natapol2547/YBR-Tawan/Robot Documentation/YBR-Tawan.pdf

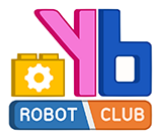
[picture p3: figure]

## YBR-Tawan

## WRO Future Engineer

## Documentation

## (Thai-version)

เอกสารนแบ่ง ี้ ออกเป็น

1. รูปภาพทีมงานและรถ
2. ข้อมูลทางวิศวกรรม
2.1 | การจัดการการเคลื่อนไหว
2.2 | การจัดการพลังงานและการตรวจเช็ค
2.3 | การจัดการอุปสรรค
2.4 | ปัจจัยทางวิศวกรรม
3. Youtube Link
4. Github link

## รูปภาพหุ่น

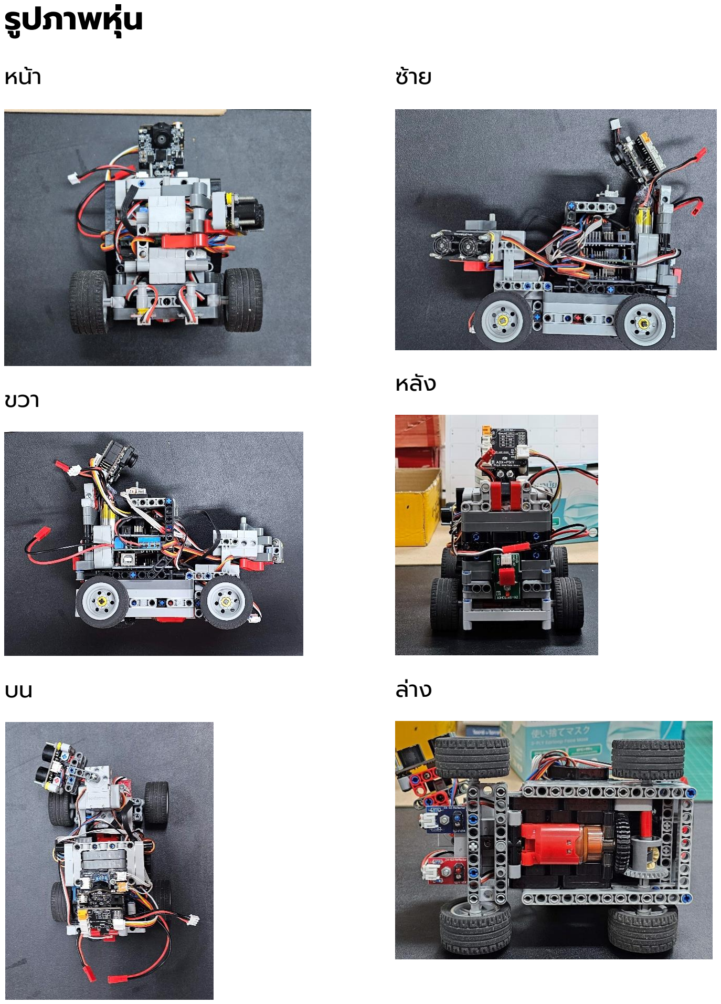
[picture p4: page 3]

หน้า

ขวา

บน

ซ้าย

หลัง

ล่าง

## รูปภาพทีมงาน

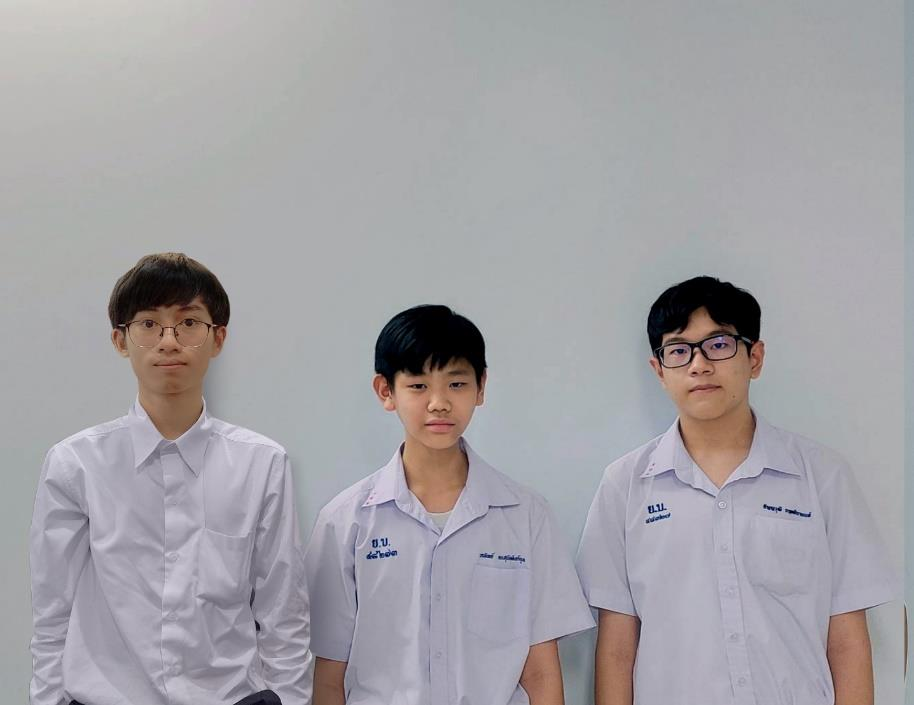
[picture p5: figure]
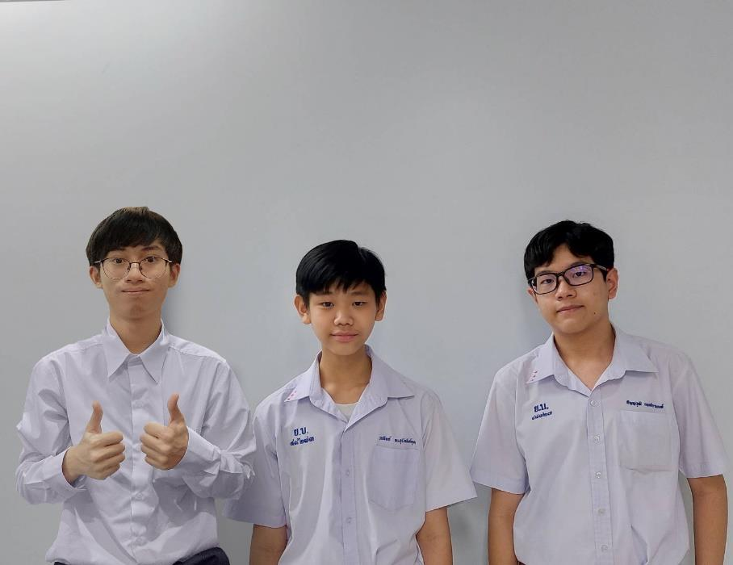
[picture p6: figure]

## 2. ข้อมูลทางวิศวกรรม

### 2.1 การจัดการการเคลื่อนไหว

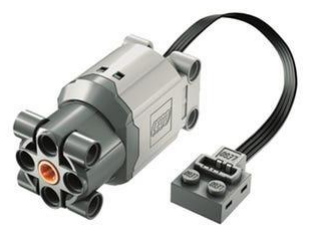
[picture p7: figure]

### เราใช้ Power Functions L-Motor ใน การขับเคลื่อนของหุ่น

เป็นมอเตอรท์ ี่ง่ายและ เราเลือกมอเตอร์นี้เนื่องจาก ความง่ายต่อการเชื่อมต่อมอเตอรเข้ากับ ์ หุ่นยนต์ของ เรา และมอเตอร์นกี้ ็มีราคาที่ถกู อีกดว้ ย

ข้อมูลทางเทคนิค

น ้าหนัก:

ความเร็วสูงสุด และ ปริมาณ
กระแสไฟฟ้า

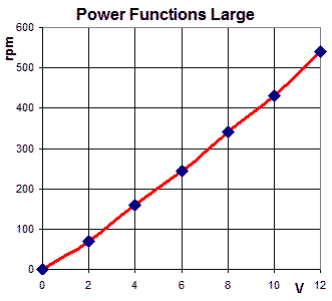
[picture p8: figure]

ความเร็ว เทียบกับ volt

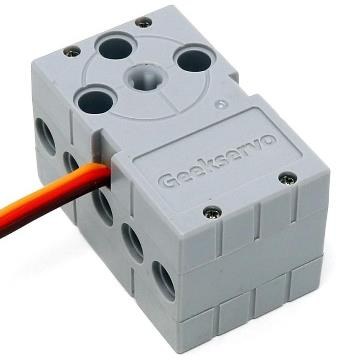
[picture p9: figure]

### เราใช้ Geekservo 2kg 360 Degrees ในการเลี้ยวของหุ่น และใช้หมุน Ultrasonic

### Sensor

เป็น servo ที่ใช้ได้กับ LEGO ใช้ง่ายและสะดวกต่อการ

สร้างหุ่น

ข้อมูลทางเทคนิค

- ความเร็วในการหมุนแกน 60 องศา/0.12 วินาที
- แรงบิด 2 กิโลกรัม.เซนตเิมตร ทไี่ ฟเลี้ยง 4.8V
- กระแสไฟฟ้าขณะไม่มีโหลด 20 ถึง 50mA
- กระแสไฟฟ้าขณะบังคับแกนหมุน (Stall) 600 ถึง 700mA
- กระแสไฟฟ้าสงบขณะหยุดท างาน 7mA
- ความกว้างของสัญญาณพัลส์ที่ต้องการ 0.6 ถงึ 2.4 มิลลิวินาที
- หมุนได้ 0 ถึง 360 องศา

Code การหมุน servo

void steering_servo(int degree) {

servo1.write((90 + max(min(degree, 45), -45)) / 2); }

### 2.2 การจัดการพลังงานและการตรวจเช็ค

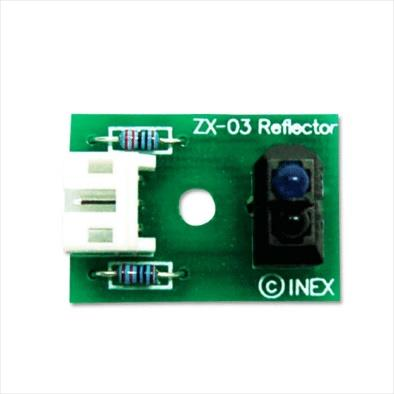
[picture p10: figure]

### เราใช้ ZX-03 Reflector ในการตรวจค่าสี บนสนาม 2 ตัว (แดง และ น ้าเงิน)

Light Reflector นี้เป็น sensor ที่ใช้วัดค่าแสงสะท้อน และในสนามนี้เราใช้sensor นี้เพื่อที่จะ check เส้น ตอนที่หุ่นเลี้ยว

### เราใช้sensor GY-25 เพื่อก าหนด

### ทิศทางของหุ่นยนต์ของเราบนสนาม

เนื่องจากหนุ่ จ าเปน็ ต้องเดินเป็นเส้นตรงเป็นส่วนใหญ่ เราจึงเลือกใช้ sensor gyro เพื่อให้หุ่นรู้ทิศทางตัว

มันเอง

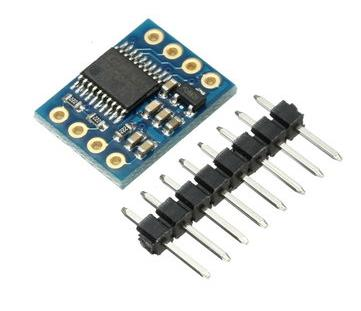
[picture p11: figure]

Dataset: http://mkpochtoi.ru/GY25_MANUAL_EN.pdf

Library: https://github.com/ElectronicCats/mpu6050

### เราใช้ Pixy 2.1 เพื่อตรวจจับสิ่งกีดขวางที่

### อยู่บนสนาม

Module กล้องตัวนี้มาพร้อม library และ function ที่ผู้พัฒนาของ pixy camera ได้ท าไว้แล้ว จึงง่ายต่อ

การใช้มาก

4’Documentaion:

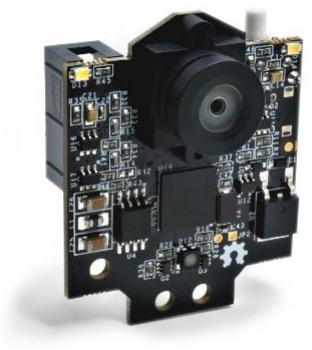
[picture p12: figure]

https://docs.pixycam.com/wiki/doku.php?id=wiki:v2:start

Software and Library: https://pixycam.com/downloads-pixy2/

### เราใช้ Ultrasonic Sensor ( SEN0307 ) เพื่อวัดระยะห่าง

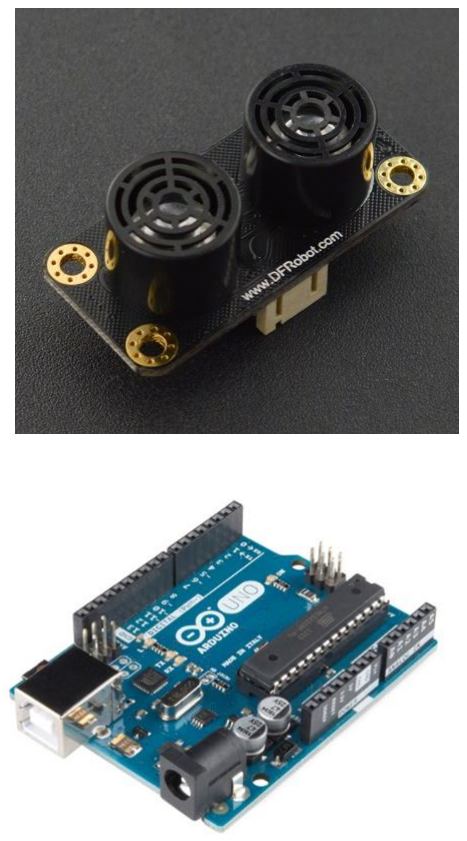
[picture p13: figure]

### ระหว่างหุ่นยนต์กับผนัง

Sensor ตัวนี้ใช้เอาต์พุตแรงดันไฟฟ้าแบบอะนาล็อก และให้การวัดระยะทางที่แม่นย าภายใน 2-500 ซม. ด้วย ความละเอียด 1 ซม. และความแม่นย า ±1% ซึ่มเหมาะกัน การแข่งขันนี้มาก

### เราใช้ Arduino UNO สมองส าหรับ

### หุ่นยนต์ของเรา

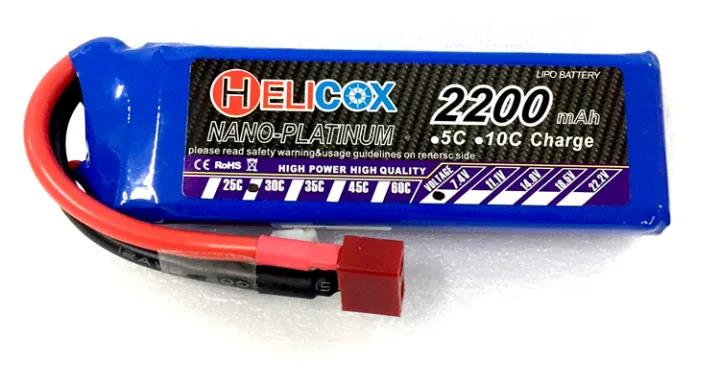
[picture p14: figure]

### เราใช้ แบตเตอรี่ลิโพ Helicox

### 2200mah (7.4V) เพื่อให้

### พลังงานหุ่นของเรา

การเดินสาย

// Motor

ENB -> Arduino UNO Pin 11

INB -> Arduino UNO Pin 13

// Servos

STEER_SRV -> Arduino UNO Pin 9

ULTRA_SRV -> Arduino UNO Pin 8

// Ultrasonic Sensor

ULTRA_DATA_PIN -> Arduino UNO Pin 2

// Light Sensors

RED_DATA_SEN -> Arduino UNO Pin 0

BLUE_DATA_SEN -> Arduino UNO Pin 1

// Button

BUTTON_DATA -> Arduino UNO Pin 3

// Pixy Camera

PIXY_SDA -> Arduino UNO Pin 4

PIXY_SCL -> Arduino UNO Pin 5

// Gryo

TX -> Arduino UNO RX

RX -> Arduino UNO TX

// Battery

BATTERY -> PWR_IN of Arduino UNO

### 2.3 การจัดการอุปสรรค

2.3.1 รอบคัดเลือก

ในรอบคัดเลือกหุ่นยนต์จะใช้ Ultrasonic sensor เพื่อค านวณระยะทางระหว่าง

ก าแพงของสนามกับหุ่น

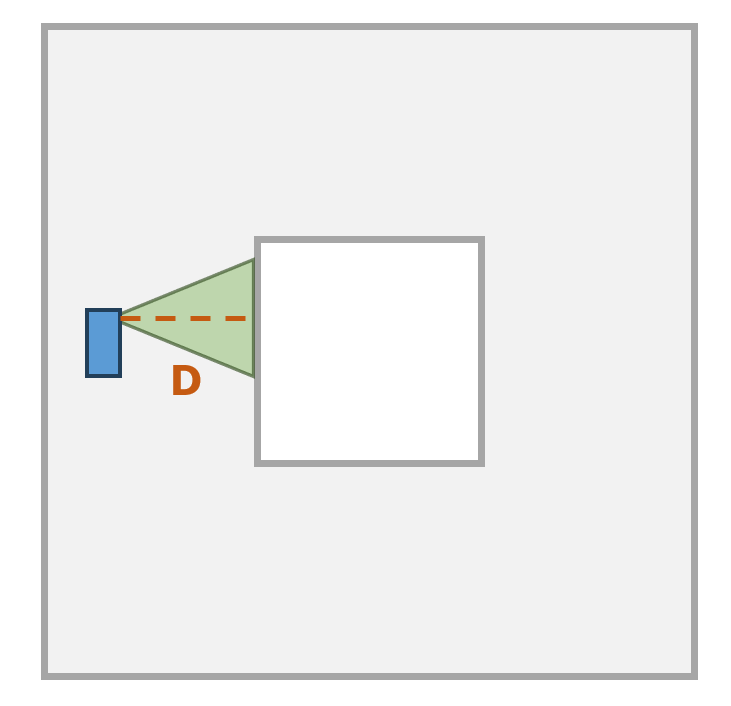
[picture p15: figure]
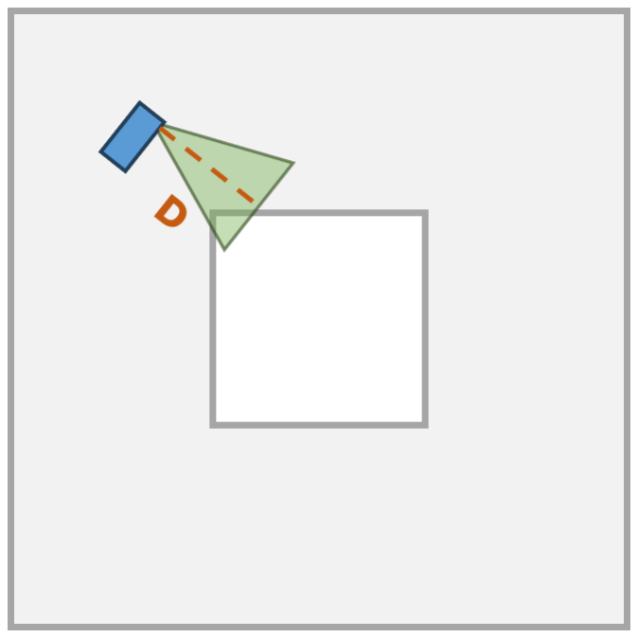
[picture p16: figure]

หุ่นจะน าระยะทางของหุ่นจากก าแพงและ องศาของ sensor gyro มาค านวณ เป็น steering degree (องศาการเลี้ยว) เพื่อใหห้ ุ่นคงระยะห่างระหว่างก าแพง

ได้ด้วยสูตร Proportional Integral Derivative (PID)

สูตรการเดิน

getIMU();

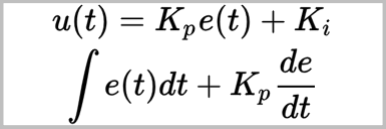
[picture p17: figure]

line_detection();
ultra_servo(pvYaw, TURN);
int wall_distance = getDistance();
motor_and_steer(-1 * compassPID.Run(pvYaw + ((wall_distance - 25) * 1) * ((float(TURN == 'R') - 0.5) * 2)));

2.3.2 รอบชิง

ในรอบคัดเลือกหุ่นยนต์จะใช้Pixy camera Ultrasonic sensor และ Gyro เพื่อน ามาค านวณ steering degree (องศาการเลยี้ ว)

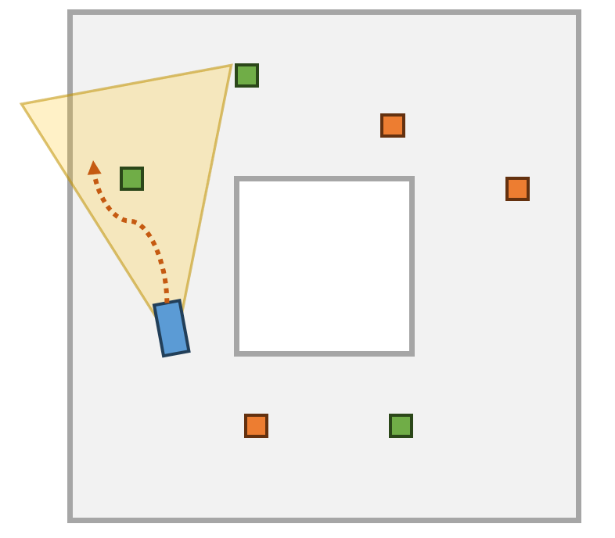
[picture p18: figure]

หุ่นยังคงใช้ PID เหมือนกับรอบคัดเลือก แตต่ ัวแปลทเี่ พิ่มขึ้นมาคือ avoidance degree (องศาในการเลี้ยวหลบ) โดย code จะเป็นดังต่อไปนี้

สูตรค านวนองศาในการเลี้ยวหลบ

float calculate_avoidance() {
int blocks = pixy.ccc.getBlocks();

found_block = false;

if (blocks) {
int signature = -1; | // Signature of the object you want to detect
int targetHeight = 10; | // Height of the object in centimeters
float focalLength = 2.3; // Focal length of the camera in centimeters float cameraFOV = 80.0; // Field of view of the camera in degrees

int largestBlockIndex = -1;
int largestBlockArea = 0;

for (int i = 0; i < blocks; i++) {
if (pixy.ccc.blocks[i].m_height > 1.33 * float(pixy.ccc.blocks[i].m_width)) {
int objectArea = pixy.ccc.blocks[i].m_width; // * pixy.ccc.blocks[i].m_height; found_block = true;
if (objectArea > largestBlockArea) { largestBlockIndex = i;
largestBlockArea = objectArea;
signature = pixy.ccc.blocks[i].m_signature; }
}
}

if (signature != -1) {
int objectHeight = pixy.ccc.blocks[largestBlockIndex].m_height; float distance = (targetHeight * focalLength * 100) / objectHeight;

float blockCenterX = pixy.ccc.blocks[largestBlockIndex].m_x; float blockCenterY = pixy.ccc.blocks[largestBlockIndex].m_y;

float deltaX = blockCenterX - pixy.frameWidth / 2;
float deltaY = blockCenterY - pixy.frameHeight / 2;

float detected_degree = deltaX * 40 / pixy.frameWidth;

float blockPositionX = distance * sin(degreesToRadians(detected_degree));
float blockPositionY = distance * cos(degreesToRadians(detected_degree))
- 17;

if (signature == 1) {

avoidance_degree = max(radiansToDegree(atan2(blockPositionX + 9, blockPositionY)), 5);
Blocks_TURN = 'R';
} else {
avoidance_degree = min(radiansToDegree(atan2(blockPositionX - 9, blockPositionY)), -5);
Blocks_TURN = 'L';
}
}
}

return avoidance_degree;
}

### 2.4 ปัจจัยทางวิศวกรรม

หุ่นที่เราสร้างขึ้นมาเป็นหุ่นที่ออกแบบมาเพื่อใช้ส าหรับงานนี้โดยเฉพาะ โดยใช้ ชิ้นส่วน LEGO และน็อตต่างๆ ในการยึดชิ้นส่วนของหุ่นเข้าดว้ ยกัน

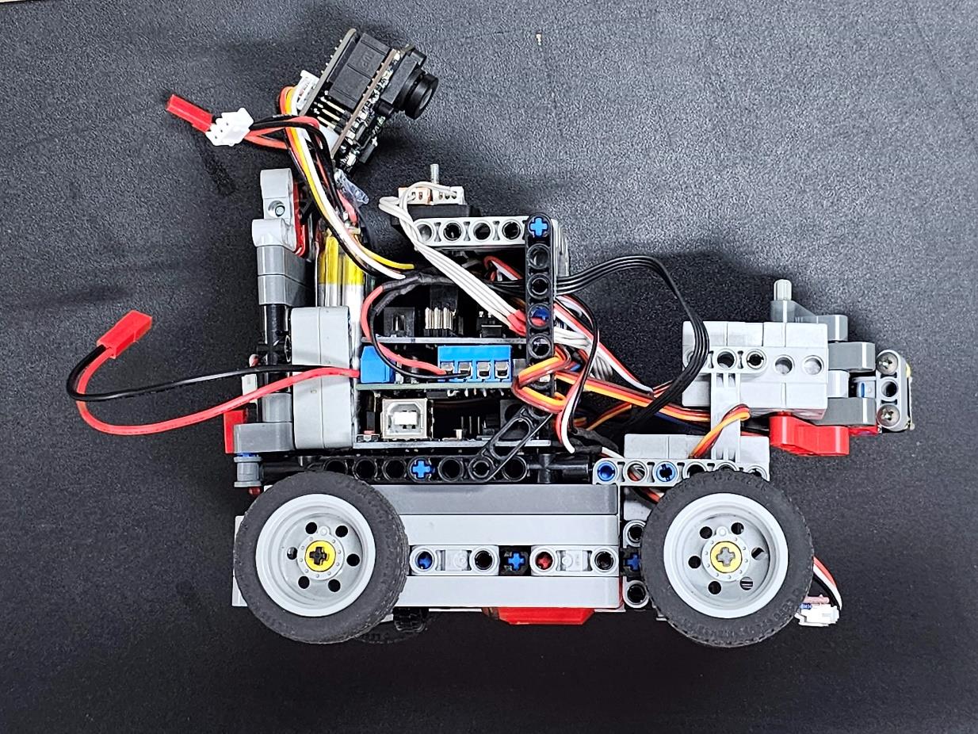
[picture p19: figure]

ปัญหาของหุ่นทเรา ี่ พบ

1. แรงบิดของมอเตอร์
มอเตอร์ตวั นี้มีแรงบิดอยู่ที่ 18 N.cm ซึ่งเราพบว่าหาก รันมอเตอร์โดยใช้ แบตเตอรี่ลิโพ 7.4V ที่ power ประมาณ 20-30% จะสามารถท าให้ หุ่นยนต์เริ่มเคลื่อนที่ได้
2. แบตเตอรี่ลิโพ
เนื่องจาก Arduino UNO ไม่มี indicator ที่ใชเตือนว่า ้ | แบตเตอรี่หมด
เราจึงต้องวัด แบตเตอรี่อยู่ตลอด แบตเตอรี่ ไม่ควรมีประจุต ่ากว่า 7.7V

เพราะค่าของ Program อาจจะผิดพลาดได้

3. Gyro Drift
หมายถึงปรากฏการณ์ที่เอาต์พุตของไจโรสโคปค่อยๆ เบี่ยงเบนไปจาก ค่าที่คาดไว้เมื่อเวลาผ่านไป เพราะฉะนั้นตอนเปิดหุ่นของเรา จ าเป็นต้อง วางหุ่นไว้ที่พื้นสนามก่อน และจึงจะค่อยๆ เสียบแบตเตอรี่ได้
4. Loose Power Connection
บางครั้งหุ่นจะ reset ตัวเอง เหตกุ ารณ์นี้เกดิ จากสายที่เสียบเข้าที่

Arduino UNO อาจจะหลวม หรือไม่ได้บัดกรีสายก่อน ท าให้ไม่สามารถส่ง ไฟฟา้ ไปที่ Pixy camera, Ultrasonic sensor, Light sensor 2 ตัว, Gyro sensor, servo และ motor ได้อย่างทั่วถงึ

### 3. YouTube Video

Qualification Round (ท าภารกิจส าเร็จประมาณ 37 วินาที)

https://youtu.be/zxlOy2REIk4

Final Round (ท าภารกิจส าเร็จประมาณ 45 วินาที)

https://youtu.be/RNagUxmCIuk

### 4. GitHub link

https://github.com/natapol2547/YBR-Tawan

YB Robot Club [YBR-Tawan]
