natapol2547/YBR-Tawan/Youtube links/Youtube links.md

Qualification Round (ทำภารกิจสำเร็จประมาณ 37 วินาที)
https://youtu.be/zxlOy2REIk4

Final Round (ทำภารกิจสำเร็จประมาณ 45 วินาที)
https://youtu.be/RNagUxmCIuk
