natapol2547/YBR-Tawan/Robot Picture/Robot Back.jpg

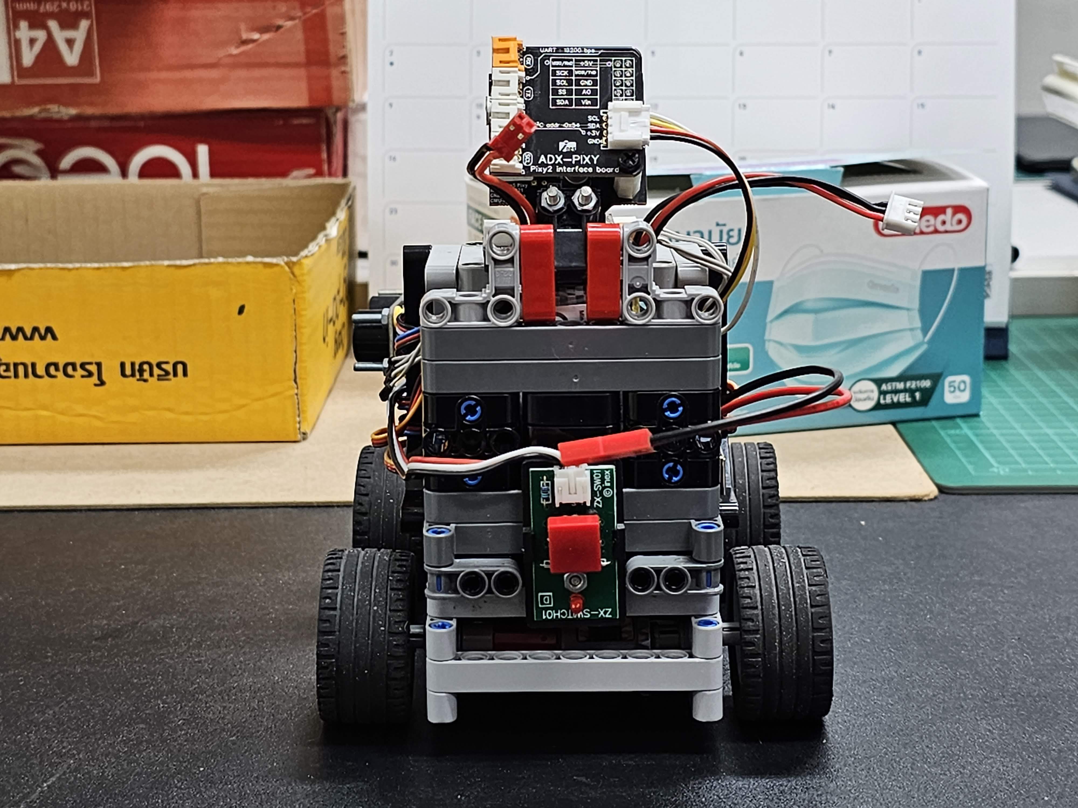
Robot Picture/Robot Back.jpg
