natapol2547/YBR-Tawan/Robot Picture/Robot Bottom.jpg

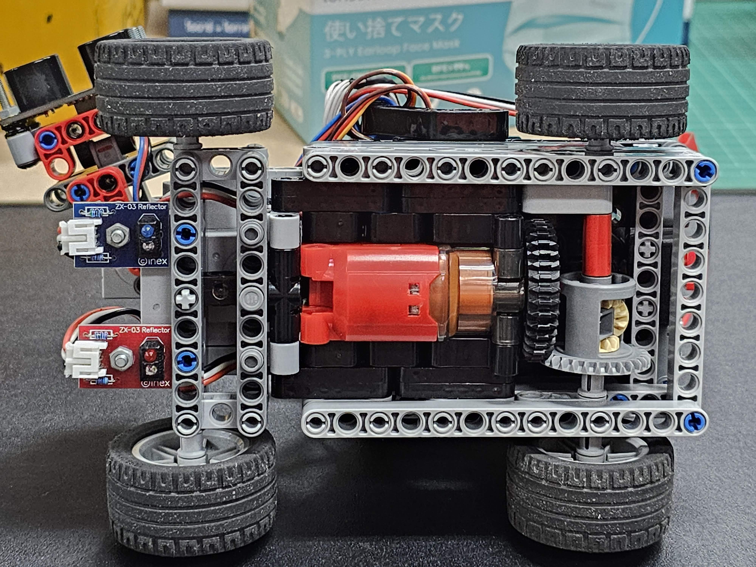
Robot Picture/Robot Bottom.jpg
