natapol2547/YBR-Tawan/Robot Picture/Robot Front.jpg

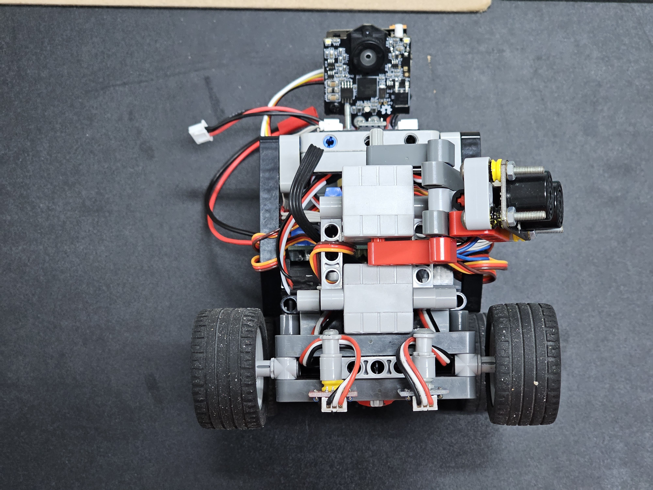
Robot Picture/Robot Front.jpg
