natapol2547/YBR-Tawan/Robot Picture/Robot Left.jpg

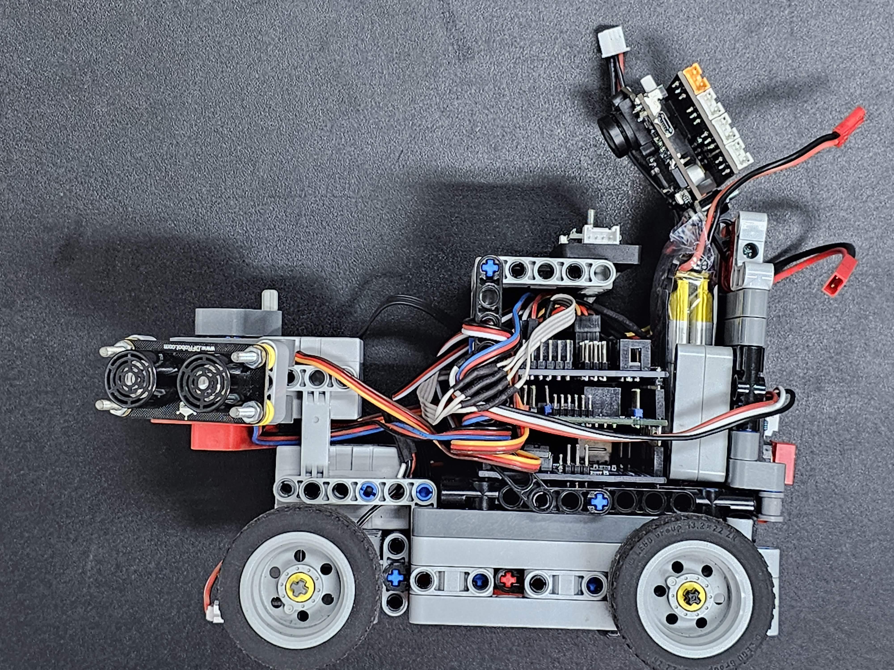
Robot Picture/Robot Left.jpg
