natapol2547/YBR-Tawan/Robot Picture/Robot Top.jpg

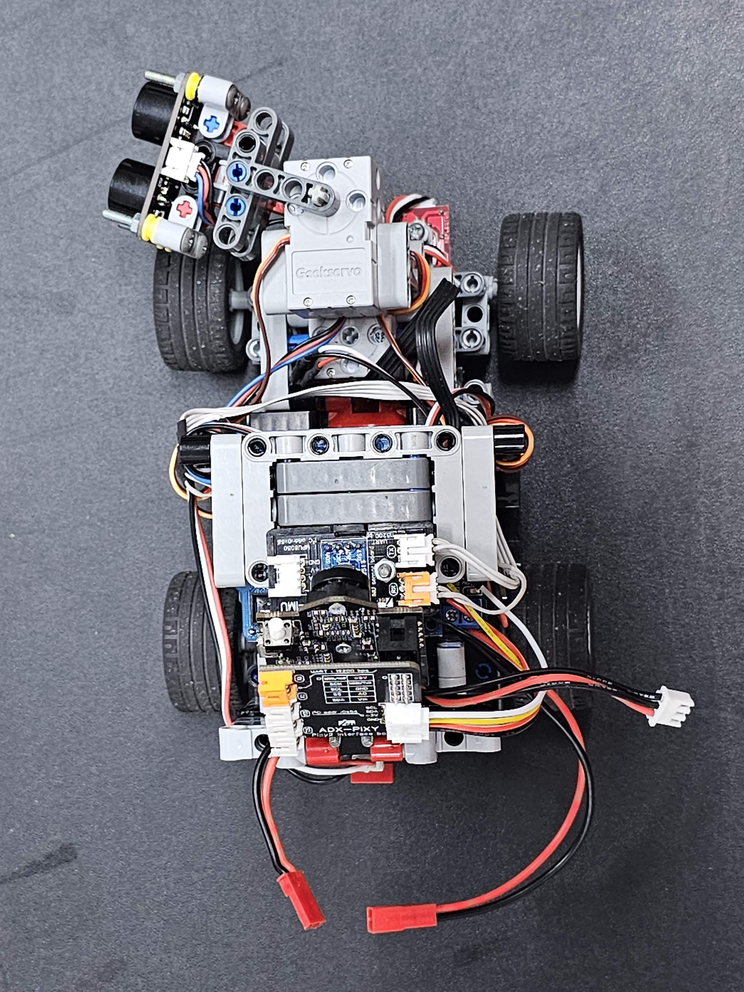
Robot Picture/Robot Top.jpg
